kvoit/TeensyCamController/cad_v1/front_arne.dxf

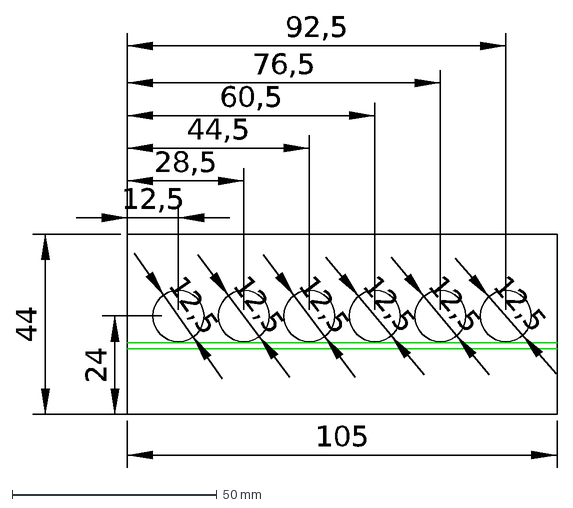
[picture p1: CAD file, 2018-01-15]
cad_v1/front_arne.dxf
105
44
24
28,5
12,5
92,5
76,5
60,5
44,5
