kvoit/TeensyCamController/cad_v1/side_arne.dxf

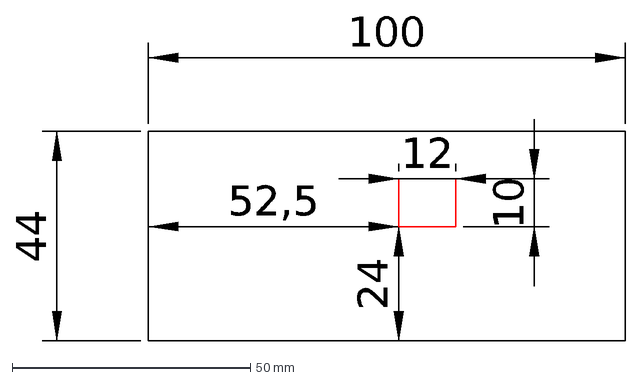
[picture p2: CAD file, 2018-01-15]
cad_v1/side_arne.dxf
44
100
24
52,5
12
10
