kvoit/TeensyCamController/cad_v1/back.dxf

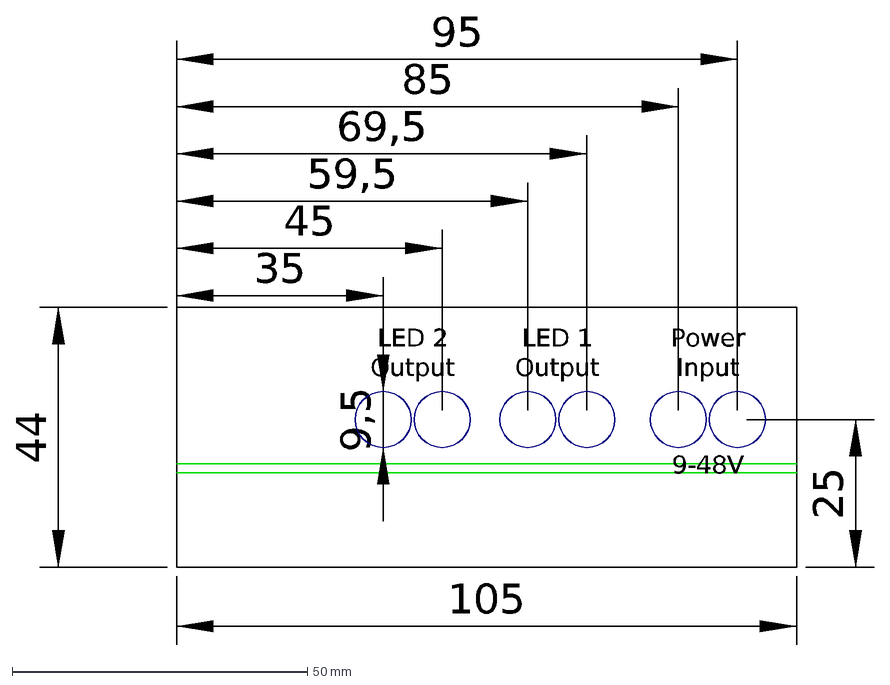
[picture p3: CAD file, 2018-01-15]
cad_v1/back.dxf
105
44
35
45
59,5
69,5
85
95
9,5
25
Power Input
LED 1 Output
LED 2 Output
9-48V
