kvoit/TeensyCamController/cad_v1/side.dxf

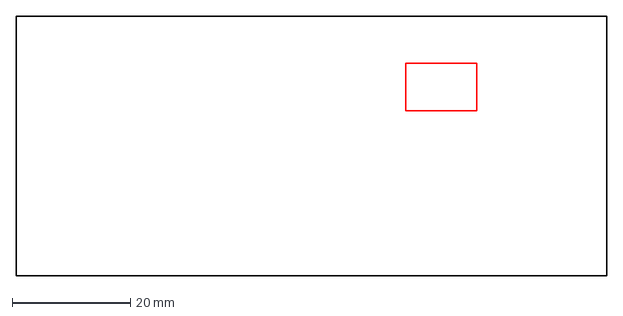
[picture p4: CAD file, 2018-01-15]
cad_v1/side.dxf
100.0 x 44.0 mm
