kvoit/TeensyCamController/cad_v1/front.dxf

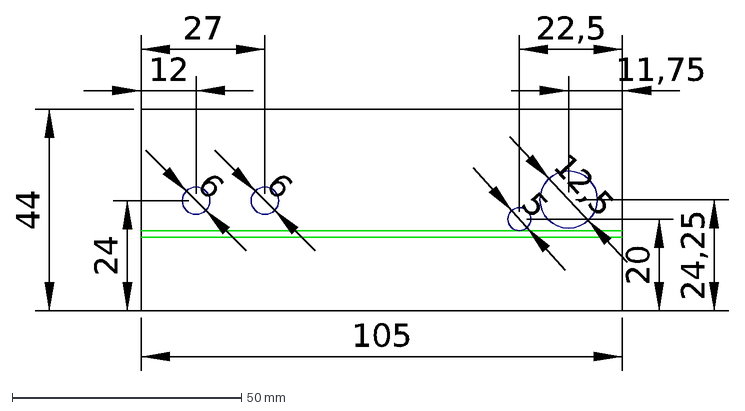
[picture p5: CAD file, 2018-01-15]
cad_v1/front.dxf
105
44
24
12
27
11,75
22,5
5
12,5
20
24,25
6
