kvoit/TeensyCamController/ledflashcontroller.kicad_pcb

## KiCad design ledflashcontroller.kicad_pcb (2017-10-26)

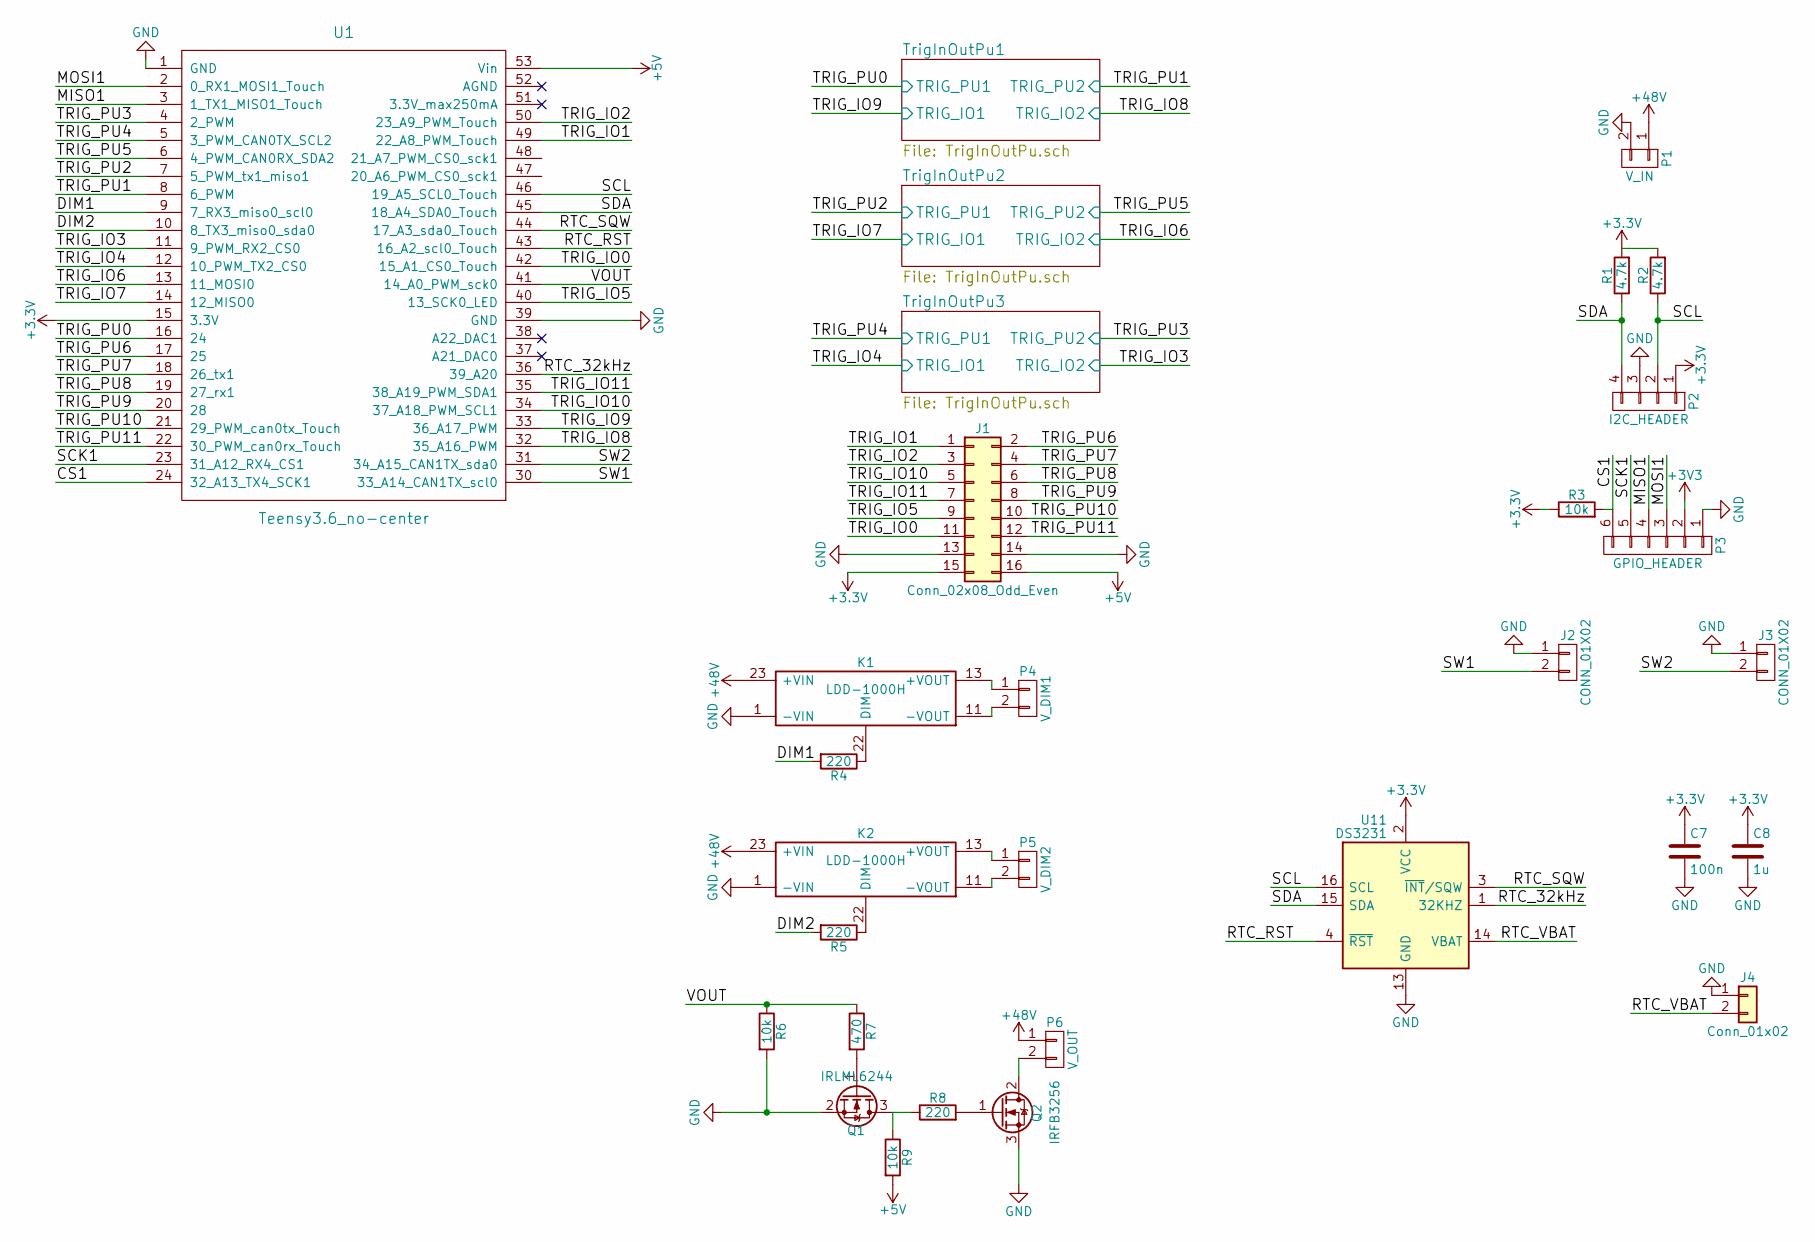
[picture p6: schematic ledflashcontroller.sch, LED Light and Flash Controller]

Parts:
C7: 100n; C_0603
C8: 1u; C_0603
J1: Conn_02x08_Odd_Even; Pin_Header_Straight_2x08_Pitch2.54mm_SMD
J2, J3: CONN_01X02; Pin_Header_Straight_1x02_Pitch2.54mm
J4: Conn_01x02; Pin_Header_Straight_1x02_Pitch2.54mm
K1, K2: LDD-1000H
P1: V_IN; DELTRON_571_x2
P2: I2C_HEADER; Pin_Header_Straight_1x04_Pitch2.54mm
P3: GPIO_HEADER; Pin_Header_Straight_1x06_Pitch2.54mm
P4: V_DIM1; DELTRON_571_x2
P5: V_DIM2; DELTRON_571_x2
P6: V_OUT; DELTRON_571_x2
Q1: IRLML6244; SOT-23_Handsoldering
Q2: IRFB3256; TO-220_Vertical
R1, R2: 4.7k; R_1206_HandSoldering
R3, R6, R9: 10k; R_1206_HandSoldering
R4, R5, R8: 220; R_1206_HandSoldering
R7: 470; R_1206_HandSoldering
U1: Teensy3.6_no-center; Teensy35_36_no-center
U11: DS3231; SOIC-16W_7.5x10.3mm_Pitch1.27mm

Connections:
+5V: J1.16, R9.2, U1.53 (Vin); also elsewhere on the board
+48V: K1.23 (+VIN), K2.23 (+VIN), P1.1, P6.1
/CS1: P3.6, R3.2, U1.24 (32_A13_TX4_SCK1)
/DIM1: R4.2, U1.9 (7_RX3_miso0_scl0)
/DIM2: R5.2, U1.10 (8_TX3_miso0_sda0)
/MISO1: P3.4, U1.3 (1_TX1_MISO1_Touch)
/MOSI1: P3.3, U1.2 (0_RX1_MOSI1_Touch)
/RTC_32kHz: U1.36 (39_A20), U11.1 (32KHZ)
/RTC_RST: U1.43 (16_A2_scl0_Touch), U11.4 (~RST)
/RTC_SQW: U1.44 (17_A3_sda0_Touch), U11.3 (~INT~/SQW)
/RTC_VBAT: J4.2, U11.14 (VBAT)
/SCK1: P3.5, U1.23 (31_A12_RX4_CS1)
/SCL: P2.2, R2.1, U1.46 (19_A5_SCL0_Touch), U11.16 (SCL)
/SDA: P2.4, R1.1, U1.45 (18_A4_SDA0_Touch), U11.15 (SDA)
/SW1: J2.2, U1.30 (33_A14_CAN1TX_scl0)
/SW2: J3.2, U1.31 (34_A15_CAN1TX_sda0)
/TRIG_IO0: J1.11, U1.42 (15_A1_CS0_Touch)
/TRIG_IO1: J1.1, U1.49 (22_A8_PWM_Touch)
/TRIG_IO2: J1.3, U1.50 (23_A9_PWM_Touch)
/TRIG_IO3: U1.11 (9_PWM_RX2_CS0); also elsewhere on the board
/TRIG_IO4: U1.12 (10_PWM_TX2_CS0); also elsewhere on the board
/TRIG_IO5: J1.9, U1.40 (13_SCK0_LED)
/TRIG_IO6: U1.13 (11_MOSI0); also elsewhere on the board
/TRIG_IO7: U1.14 (12_MISO0); also elsewhere on the board
/TRIG_IO8: U1.32 (35_A16_PWM); also elsewhere on the board
/TRIG_IO9: U1.33 (36_A17_PWM); also elsewhere on the board
/TRIG_IO10: J1.5, U1.34 (37_A18_PWM_SCL1)
/TRIG_IO11: J1.7, U1.35 (38_A19_PWM_SDA1)
/TRIG_PU0: U1.16 (24); also elsewhere on the board
/TRIG_PU1: U1.8 (6_PWM); also elsewhere on the board
/TRIG_PU2: U1.7 (5_PWM_tx1_miso1); also elsewhere on the board
/TRIG_PU3: U1.4 (2_PWM); also elsewhere on the board
/TRIG_PU4: U1.5 (3_PWM_CAN0TX_SCL2); also elsewhere on the board
/TRIG_PU5: U1.6 (4_PWM_CAN0RX_SDA2); also elsewhere on the board
/TRIG_PU6: J1.2, U1.17 (25)
/TRIG_PU7: J1.4, U1.18 (26_tx1)
/TRIG_PU8: J1.6, U1.19 (27_rx1)
/TRIG_PU9: J1.8, U1.20 (28)
/TRIG_PU10: J1.10, U1.21 (29_PWM_can0tx_Touch)
/TRIG_PU11: J1.12, U1.22 (30_PWM_can0rx_Touch)
/VOUT: R6.1, R7.1, U1.41 (14_A0_PWM_sck0)
GND: C7.2, C8.2, J1.13, J1.14, J2.1, J3.1, J4.1, K1.1 (-VIN), K2.1 (-VIN), P1.2, P2.3, P3.1, Q1.2 (S), Q2.3 (S), R6.2, U1.1 (GND), U1.39 (GND), U11.5 (NC), U11.6 (NC), U11.7 (NC), U11.8 (NC), U11.9 (NC), U11.10 (NC), U11.11 (NC), U11.12 (NC), U11.13 (GND); also elsewhere on the board
unnamed: K1.11 (-VOUT), P4.2
unnamed: K1.13 (+VOUT), P4.1
unnamed: K1.22 (DIM), R4.1
unnamed: K2.11 (-VOUT), P5.2
unnamed: K2.13 (+VOUT), P5.1
unnamed: K2.22 (DIM), R5.1
unnamed: P6.2, Q2.2 (D)
unnamed: Q1.1 (G), R7.2
unnamed: Q1.3 (D), R8.1, R9.1
unnamed: Q2.1 (G), R8.2

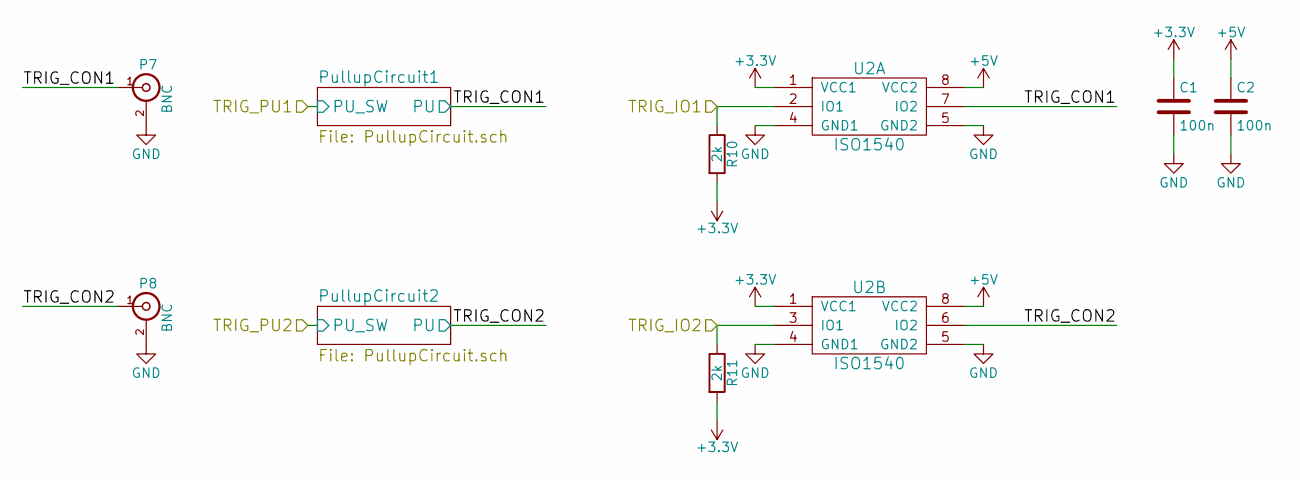
[picture p7: schematic TrigInOutPu.sch]

Parts:
C1, C2: 100n; C_0603_HandSoldering
P7, P8: BNC; BNC_Socket_RSpro_LargePads
R10, R11: 2k; R_0603_HandSoldering
U2: ISO1540; SOIC-8_3.9x4.9mm_Pitch1.27mm

Connections:
+5V: C2.1, U2.8 (VCC2); also elsewhere on the board
/TRIG_IO8: R11.1, U2.3 (IO1); also elsewhere on the board
/TRIG_IO9: R10.1, U2.2 (IO1); also elsewhere on the board
/TrigInOutPu1/TRIG_CON1: P7.1 (In), U2.7 (IO2); also elsewhere on the board
/TrigInOutPu1/TRIG_CON2: P8.1 (In), U2.6 (IO2); also elsewhere on the board
GND: C1.2, C2.2, P7.2 (Ext), P8.2 (Ext), U2.4 (GND1), U2.5 (GND2); also elsewhere on the board

Parts of its further copies:
C3, C4, C5, C6: 100n; C_0603_HandSoldering
P9, P10, P11, P12: BNC; BNC_Socket_RSpro_LargePads
R18, R19, R26, R27: 2k; R_0603_HandSoldering
U5, U8: ISO1540; SOIC-8_3.9x4.9mm_Pitch1.27mm

Connections of its further copies:
+5V: C4.1, C6.1, U5.8 (VCC2), U8.8 (VCC2); also elsewhere on the board
/TRIG_IO3: R27.1, U8.3 (IO1); also elsewhere on the board
/TRIG_IO4: R26.1, U8.2 (IO1); also elsewhere on the board
/TRIG_IO6: R19.1, U5.3 (IO1); also elsewhere on the board
/TRIG_IO7: R18.1, U5.2 (IO1); also elsewhere on the board
/TrigInOutPu2/TRIG_CON1: P9.1 (In), U5.7 (IO2); also elsewhere on the board
/TrigInOutPu2/TRIG_CON2: P10.1 (In), U5.6 (IO2); also elsewhere on the board
/TrigInOutPu3/TRIG_CON1: P11.1 (In), U8.7 (IO2); also elsewhere on the board
/TrigInOutPu3/TRIG_CON2: P12.1 (In), U8.6 (IO2); also elsewhere on the board
GND: C3.2, C4.2, C5.2, C6.2, P9.2 (Ext), P10.2 (Ext), P11.2 (Ext), P12.2 (Ext), U5.4 (GND1), U5.5 (GND2), U8.4 (GND1), U8.5 (GND2); also elsewhere on the board

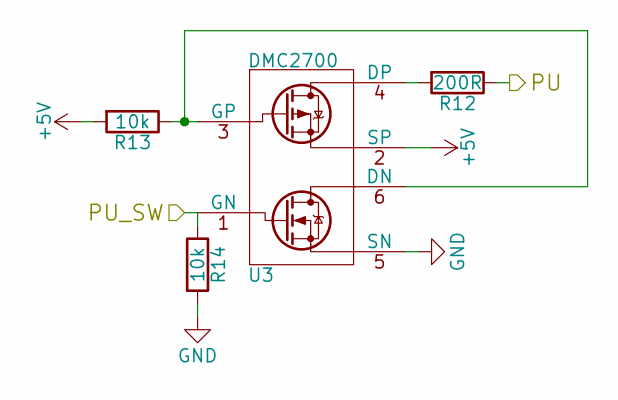
[picture p8: schematic PullupCircuit.sch]

Parts:
R12: 200R; R_1206_HandSoldering
R13, R14: 10k; R_0603_HandSoldering
U3: DMC2700; SOT-23-6_Handsoldering

Connections:
+5V: R13.2, U3.2 (SP); also elsewhere on the board
/TRIG_PU0: R14.1, U3.1 (GN); also elsewhere on the board
/TrigInOutPu1/TRIG_CON1: R12.1; also elsewhere on the board
GND: R14.2, U3.5 (SN); also elsewhere on the board
unnamed: R12.2, U3.4 (DP)
unnamed: R13.1, U3.3 (GP), U3.6 (DN)

Parts of its further copies:
R15, R20, R23, R28, R31: 200R; R_1206_HandSoldering
R16, R17, R21, R22, R24, R25, R29, R30, R32, R33: 10k; R_0603_HandSoldering
U4, U6, U7, U9, U10: DMC2700; SOT-23-6_Handsoldering

Connections of its further copies:
+5V: R16.2, R21.2, R24.2, R29.2, R32.2, U4.2 (SP), U6.2 (SP), U7.2 (SP), U9.2 (SP), U10.2 (SP); also elsewhere on the board
/TRIG_PU1: R17.1, U4.1 (GN); also elsewhere on the board
/TRIG_PU2: R22.1, U6.1 (GN); also elsewhere on the board
/TRIG_PU3: R33.1, U10.1 (GN); also elsewhere on the board
/TRIG_PU4: R30.1, U9.1 (GN); also elsewhere on the board
/TRIG_PU5: R25.1, U7.1 (GN); also elsewhere on the board
/TrigInOutPu1/TRIG_CON2: R15.1; also elsewhere on the board
/TrigInOutPu2/TRIG_CON1: R20.1; also elsewhere on the board
/TrigInOutPu2/TRIG_CON2: R23.1; also elsewhere on the board
/TrigInOutPu3/TRIG_CON1: R28.1; also elsewhere on the board
/TrigInOutPu3/TRIG_CON2: R31.1; also elsewhere on the board
GND: R17.2, R22.2, R25.2, R30.2, R33.2, U4.5 (SN), U6.5 (SN), U7.5 (SN), U9.5 (SN), U10.5 (SN); also elsewhere on the board
unnamed: R15.2, U4.4 (DP)
unnamed: R16.1, U4.3 (GP), U4.6 (DN)
unnamed: R20.2, U6.4 (DP)
unnamed: R21.1, U6.3 (GP), U6.6 (DN)
unnamed: R23.2, U7.4 (DP)
unnamed: R24.1, U7.3 (GP), U7.6 (DN)
unnamed: R28.2, U9.4 (DP)
unnamed: R29.1, U9.3 (GP), U9.6 (DN)
unnamed: R31.2, U10.4 (DP)
unnamed: R32.1, U10.3 (GP), U10.6 (DN)

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
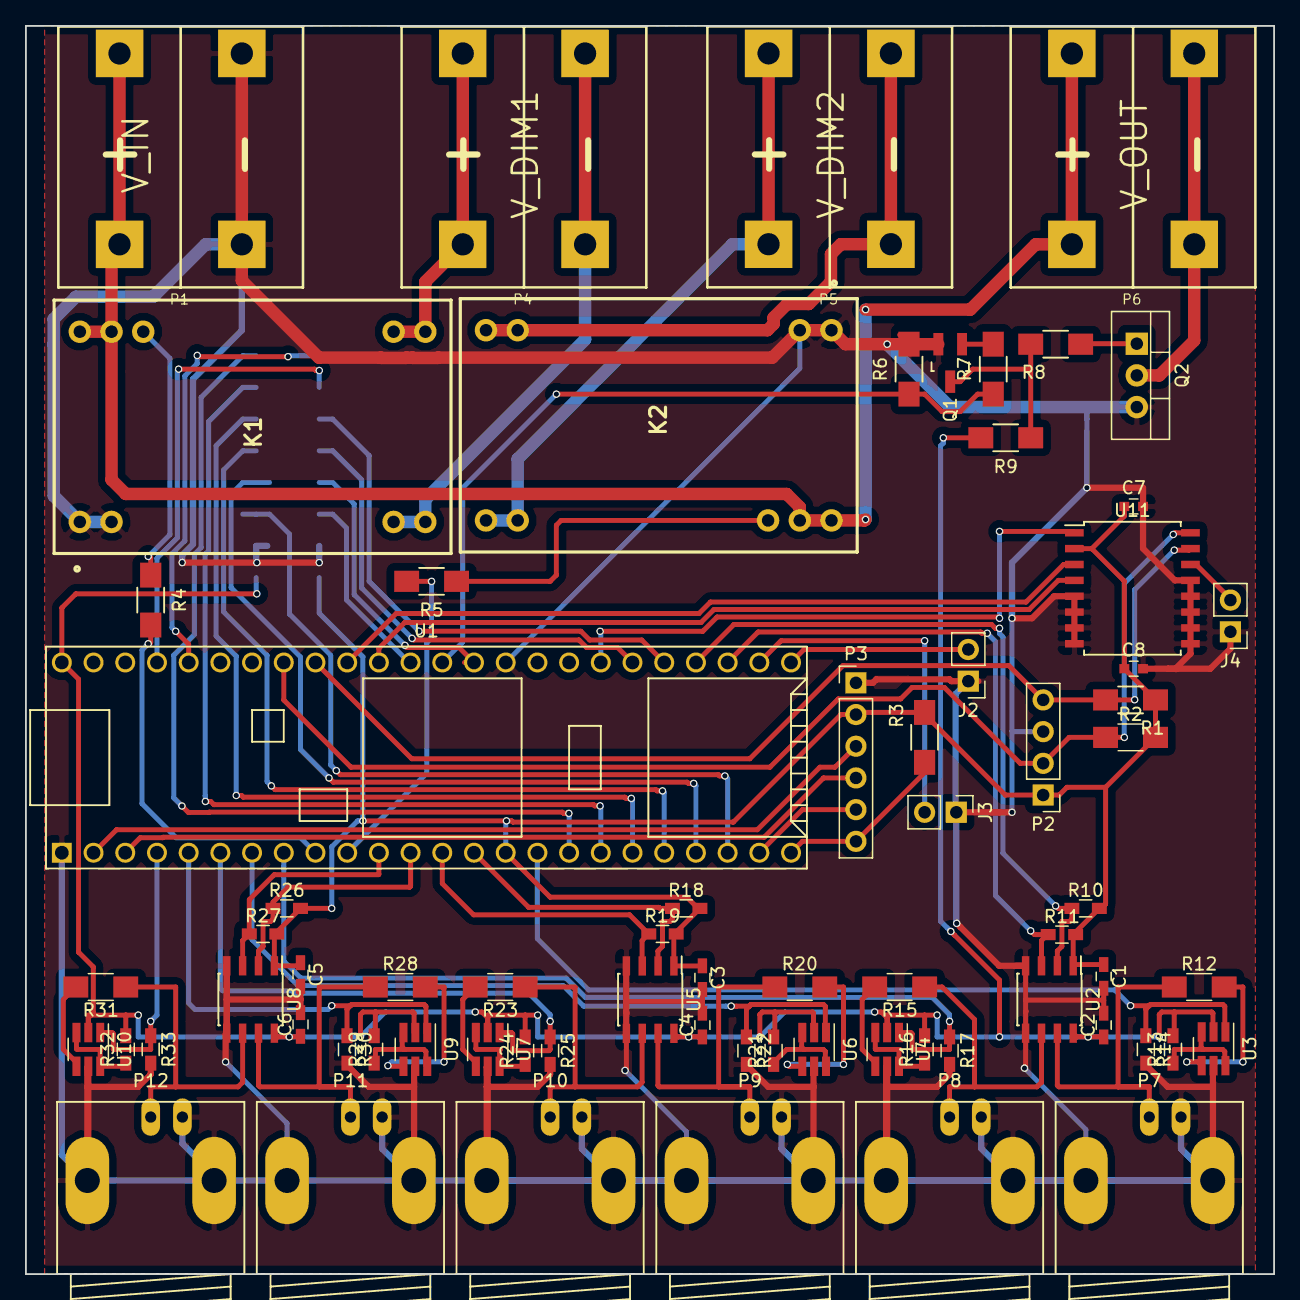
[picture p9: board ledflashcontroller.kicad_pcb from above]

Board: 2 copper layers, 100.0 x 100.0 mm, 72 parts (1 on the bottom side), 71 nets.
