kvoit/TeensyCamController/(threads)

Thread 2 (2017-10-25):

ISO1540 decoupling

kvoit, 2017-10-25:
Cap C5 (and equivalent) GND is not closely connected to IC GND. This was changed from the initial push.

kvoit, 2017-10-25:
Fixed pushed for U8, to be applied to other ISO1540

arnemonsees, 2017-10-25:
Fixed in commit 651698b57bef2fef916f34507c041d9a81d18e3f

Closed 2017-10-25.

Thread 4 (2017-10-26):

Ideas for v3

kvoit, 2017-10-26:
- Use long sockets to bring all Teensy pins to the daughter board:
http://de.rs-online.com/web/p/leiterplatten-stift-und-sockelleisten/2677438/
Would allow dual use of optional pins on the mainboard (e.g. use former RTC pins to interface GPS on daughter board).
