kvoit/TeensyCamController/(commit log)

2017-09-12 Initial commi
    [MAX5033-supply.sch, PullupCircuit.sch, TrigInOutPu.sch, _saved_TrigInOutPu.sch, _saved_ledflashcontroller.sch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]
2017-10-20 Fixed some annotations and footprints
    [PullupCircuit.sch, TrigInOutPu.sch, _saved_TrigInOutPu.sch, _saved_ledflashcontroller.sch, ledflashcontroller.kicad_pcb, ledflashcontroller.sch]
2017-10-23 Restructured existing connections and aligned everythink to grid
    [ledflashcontroller.kicad_pcb]
2017-10-23 Duplicated existing circuits
    [ledflashcontroller.kicad_pcb]
2017-10-23 Fixed bugs (wires to close to pads)
    [ledflashcontroller.kicad_pcb]
2017-10-23 Connected circuits to Teensy
    [_saved_ledflashcontroller.sch, ledflashcontroller.kicad_pcb]
2017-10-23 Changed double-usage of pins
    [ledflashcontroller.kicad_pcb]
2017-10-23 Arranged components so that they are close to their respective circuits
    [ledflashcontroller.kicad_pcb]
2017-10-23 Bugfixes for vias to close to wires
    [_saved_ledflashcontroller.sch, ledflashcontroller.kicad_pcb, ledflashcontroller.sch]
2017-10-23 Completed Ratsnest
    [ledflashcontroller.kicad_pcb]
2017-10-23 Push to update all files
    [PullupCircuit.sch, TrigInOutPu.sch, _saved_ledflashcontroller.sch, ledflashcontroller.sch]
2017-10-23 Added RTC in schematic
    [_saved_ledflashcontroller.sch]
2017-10-23 RTC update
    [PullupCircuit.sch, TrigInOutPu.sch, _saved_ledflashcontroller.sch, ledflashcontroller.kicad_pcb, ledflashcontroller.sch]
2017-10-23 Connected RTC and git tried to get rid of vias
    [ledflashcontroller.kicad_pcb]
2017-10-23 Minor change in wireing
    [ledflashcontroller.kicad_pcb]
2017-10-24 Minor change in wiring again
    [ledflashcontroller.kicad_pcb]
2017-10-24 Added groundplane
    [ledflashcontroller.kicad_pcb]
2017-10-25 fixed decoupling cap for U8
    [ledflashcontroller.kicad_pcb]
2017-10-25 fixed decoupling cap for U11
    [ledflashcontroller.kicad_pcb]
2017-10-25 Fixed ISO1540 decoupling issue
    [ledflashcontroller.kicad_pcb]
2017-10-25 Cleanup teensy schematic and remove old custom.lib
    [PullupCircuit.sch, TrigInOutPu.sch, ledflashcontroller.kicad_pcb, ledflashcontroller.sch]
2017-10-25 Add 2nd teensy ground and rotate mosfet. Fixes #3
    [ledflashcontroller.kicad_pcb, ledflashcontroller.sch]
2017-10-25 Correct and add new LDD footprint to pcb
    [ledflashcontroller.kicad_pcb]
2017-10-25 Switched RTC_SQW and RTC_32kHz for improved routing
    [ledflashcontroller.kicad_pcb, ledflashcontroller.sch]
2017-10-25 Pushed some traces closer together
    [ledflashcontroller.kicad_pcb]
2017-10-26 Plot and add final v2 gerber files
    [ledflashcontroller.kicad_pcb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]
2018-01-15 Add CAD drawings for box of V1
    [back.dxf, front.dxf, side.dxf]
2018-01-15 Modified CAD drawings for the fisher-box to match v2 of the trigger box (cut outs)
    [front_arne.dxf, side_arne.dxf]
2018-01-18 Inital commit for Teensy code to send external trigger signal
2018-01-22 Modified python code for communicating with the Teensy. Enabled writing the trigger signal to a file
2018-01-23 More updates after testint with the actual setup. This seems to work now. Although, I am not sure yet if I got rid of the case where the file is closed in threat t2 while thread t1 still wants to rid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
2018-01-24 Added code so the two threads communicate correctly with each other.
    [communicate_with_teensy.py]
2018-01-24 Added timeout signal to for the read thread. Everything seems to work correctly now
    [communicate_with_teensy.py]
